arboinvest/savazo/arbo/html/img/vezerlo.png

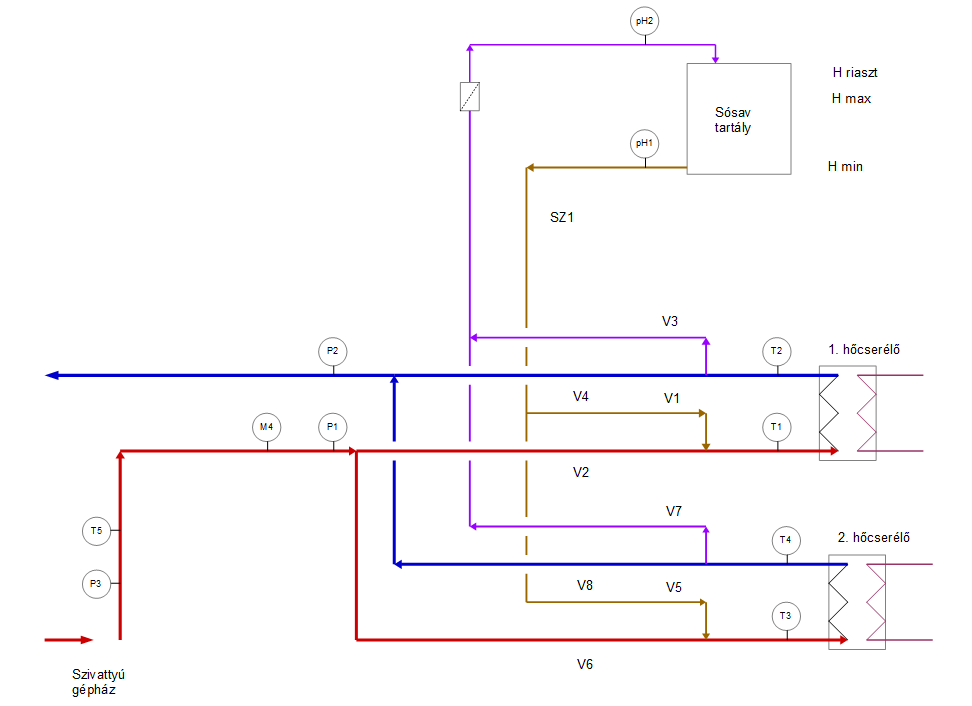
arbo/html/img/vezerlo.png
